WilleSWE/Adafroot-charger-MCP73833/KiCad project/kicad.md

This is the entire project, I'm pretty sure. Contains all of the stuff, including schematic
