WilleSWE/Adafroot-charger-MCP73833/KiCad project/Adafruit_MCP73833_PCB-master/production/bom.csv

Designator | Footprint | Quantity | Value | LCSC Part #
+ -_3 | JST_PH_B2B-PH-K_1x02_P2.00mm_Vertical | 1 | JST-PH 2.0mm
+ -_2 | Molex_PicoBlade_53047-0210_1x02_P1.25mm_Vertical | 1 | PicoBlade 1.25mm
+ - | JST_ZH_B2B-ZR_1x02_P1.50mm_Vertical | 1 | JST-ZH 1.5mm
5VIN | TestPoint_Pad_2.5x2.5mm | 1 | 5Vin
C1, C2 | 0603 | 2 | 10uF
GND | TestPoint_Pad_2.5x2.5mm | 1 | Gnd
IC1 | MSOP-10_3x3mm_P0.5mm | 1 | MCP73833-FCI_UN
J1 | USB4125GFA0190 | 1 | USB_C_Receptacle_PowerOnly_6P
J3 | PinHeader_1x02_P2.54mm_Vertical | 1 | Conn_01x02
J4 | PinHeader_2x05_P2.54mm_Vertical | 1 | Conn_02x05_Counter_Clockwise
LED1 | CHIPLED_0805 | 1 | STAT1-ORANGE
LED2 | CHIPLED_0805 | 1 | STAT2-GREEN
LED3 | CHIPLED_0805 | 1 | Power-RED
R1, R2, R3 | 0603 | 3 | 680 ohm 0603
R10 | R_Axial_DIN0207_L6.3mm_D2.5mm_P7.62mm_Horizontal | 1 | 1k ohm
R11 | R_Axial_DIN0207_L6.3mm_D2.5mm_P7.62mm_Horizontal | 1 | SPARE 2
R4 | R_Axial_DIN0207_L6.3mm_D2.5mm_P7.62mm_Horizontal | 1 | 10k ohm
R5, R6 | 0603 | 2 | 5k1
R7 | R_Axial_DIN0207_L6.3mm_D2.5mm_P7.62mm_Horizontal | 1 | 10K/THERM
R8 | R_Axial_DIN0207_L6.3mm_D2.5mm_P7.62mm_Horizontal | 1 | 4.7k ohm
R9 | R_Axial_DIN0207_L6.3mm_D2.5mm_P7.62mm_Horizontal | 1 | SPARE
