WilleSWE/Adafroot-charger-MCP73833/KiCad project/Adafruit_MCP73833_PCB-master/MCP73833_QFN_v1.0.kicad_pcb

## KiCad design KiCad project/Adafruit_MCP73833_PCB-master/MCP73833_QFN_v1.0.kicad_pcb (2026-10-17)

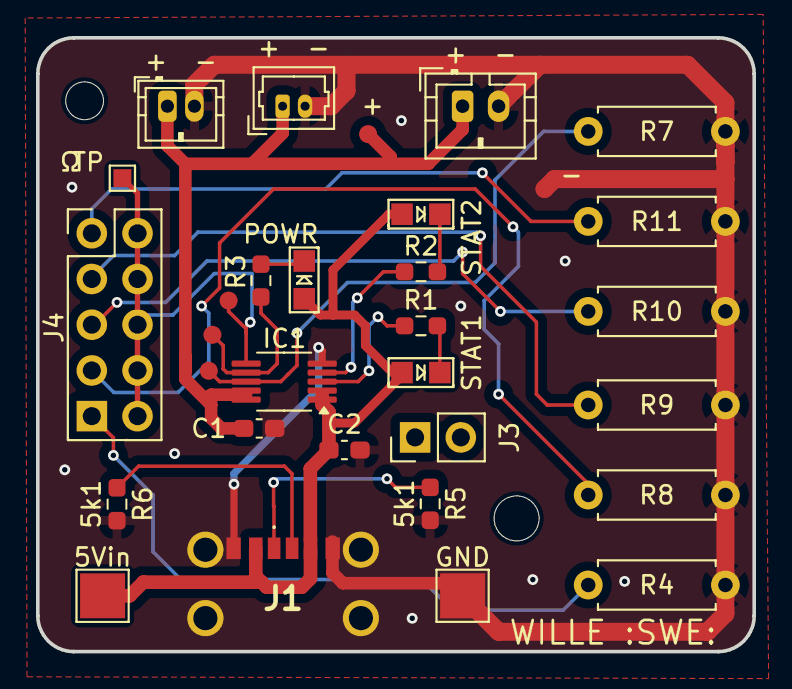
[picture p1: board MCP73833_QFN_v1.0.kicad_pcb from above]

Board: 2 copper layers, 39.8 x 34.1 mm, 26 parts (0 on the bottom side), 18 nets.

Parts:
5Vin: 5Vin; TestPoint_Pad_2.5x2.5mm
+  -: JST-PH 2.0mm; JST_PH_B2B-PH-K_1x02_P2.00mm_Vertical
+  -#2: PicoBlade 1.25mm; Molex_PicoBlade_53047-0210_1x02_P1.25mm_Vertical
+  -#3: JST-ZH 1.5mm; JST_ZH_B2B-ZR_1x02_P1.50mm_Vertical
C1, C2: 10uF; C_0603_1608Metric_Pad1.08x0.95mm_HandSolder
GND: Gnd; TestPoint_Pad_2.5x2.5mm
IC1: MCP73833-FCI_UN; MSOP-10_3x3mm_P0.5mm
J1: USB_C_Receptacle_PowerOnly_6P; USB4125GFA0190
J3: Conn_01x02; PinHeader_1x02_P2.54mm_Vertical
J4: Conn_02x05_Counter_Clockwise; PinHeader_2x05_P2.54mm_Vertical
LED1: STAT1-ORANGE; CHIPLED_0805
LED2: STAT2-GREEN; CHIPLED_0805
LED3: Power-RED; CHIPLED_0805
R1, R2, R3: 680 ohm 0603; R_0603_1608Metric_Pad0.98x0.95mm_HandSolder
R4: 10k ohm; R_Axial_DIN0207_L6.3mm_D2.5mm_P7.62mm_Horizontal
R5, R6: 5k1; R_0603_1608Metric_Pad0.98x0.95mm_HandSolder
R7: 10K/THERM; R_Axial_DIN0207_L6.3mm_D2.5mm_P7.62mm_Horizontal
R8: 4.7k ohm; R_Axial_DIN0207_L6.3mm_D2.5mm_P7.62mm_Horizontal
R9: SPARE; R_Axial_DIN0207_L6.3mm_D2.5mm_P7.62mm_Horizontal
R10: 1k ohm; R_Axial_DIN0207_L6.3mm_D2.5mm_P7.62mm_Horizontal
R11: SPARE 2; R_Axial_DIN0207_L6.3mm_D2.5mm_P7.62mm_Horizontal
TP: TestPoint_Pad_1.0x1.0mm

Connections:
5.0V: 5Vin.1, C2.1, IC1.1 (VDD_1), IC1.2 (VDD_2), J1.A9 (VBUS), J1.B9 (VBUS), LED1.A, LED2.A, LED3.A
GND: + -.2, + -#2.2, + -#3.2, C1.2, C2.2, GND.1, IC1.5 (VSS), J1.A12 (GND), J1.B12 (GND), J1.MH1, J1.MH2, J1.MH3, J1.MH4, R4.1, R5.2, R6.2, R7.1, R8.1, R9.1, R10.1, R11.1
unnamed: + -.1, + -#2.1, + -#3.1, C1.1, IC1.9 (VBAT_1), IC1.10 (VBAT_2)
unnamed: IC1.6 (PROG), J4.6, J4.7, J4.8, J4.9, J4.10, TP.1
unnamed: IC1.3 (STAT1), R1.1
unnamed: IC1.4 (STAT2), R2.1
unnamed: IC1.8 (THERM), R7.2
unnamed: IC1.7 (~PG), R3.2
unnamed: J1.A5 (CC1), R5.1
unnamed: J1.B5 (CC2), R6.1
unnamed: J4.1, R4.2
unnamed: J4.2, R8.2
unnamed: J4.3, R10.2
unnamed: J4.4, R9.2
unnamed: J4.5, R11.2
unnamed: LED1.C, R1.2
unnamed: LED2.C, R2.2
unnamed: LED3.C, R3.1
