WilleSWE/Adafroot-charger-MCP73833/KiCad project/Adafruit_MCP73833_PCB-master/MCP73833_QFN_v1.0.brd

## EAGLE design KiCad project/Adafruit_MCP73833_PCB-master/MCP73833_QFN_v1.0.brd (2026-10-17)

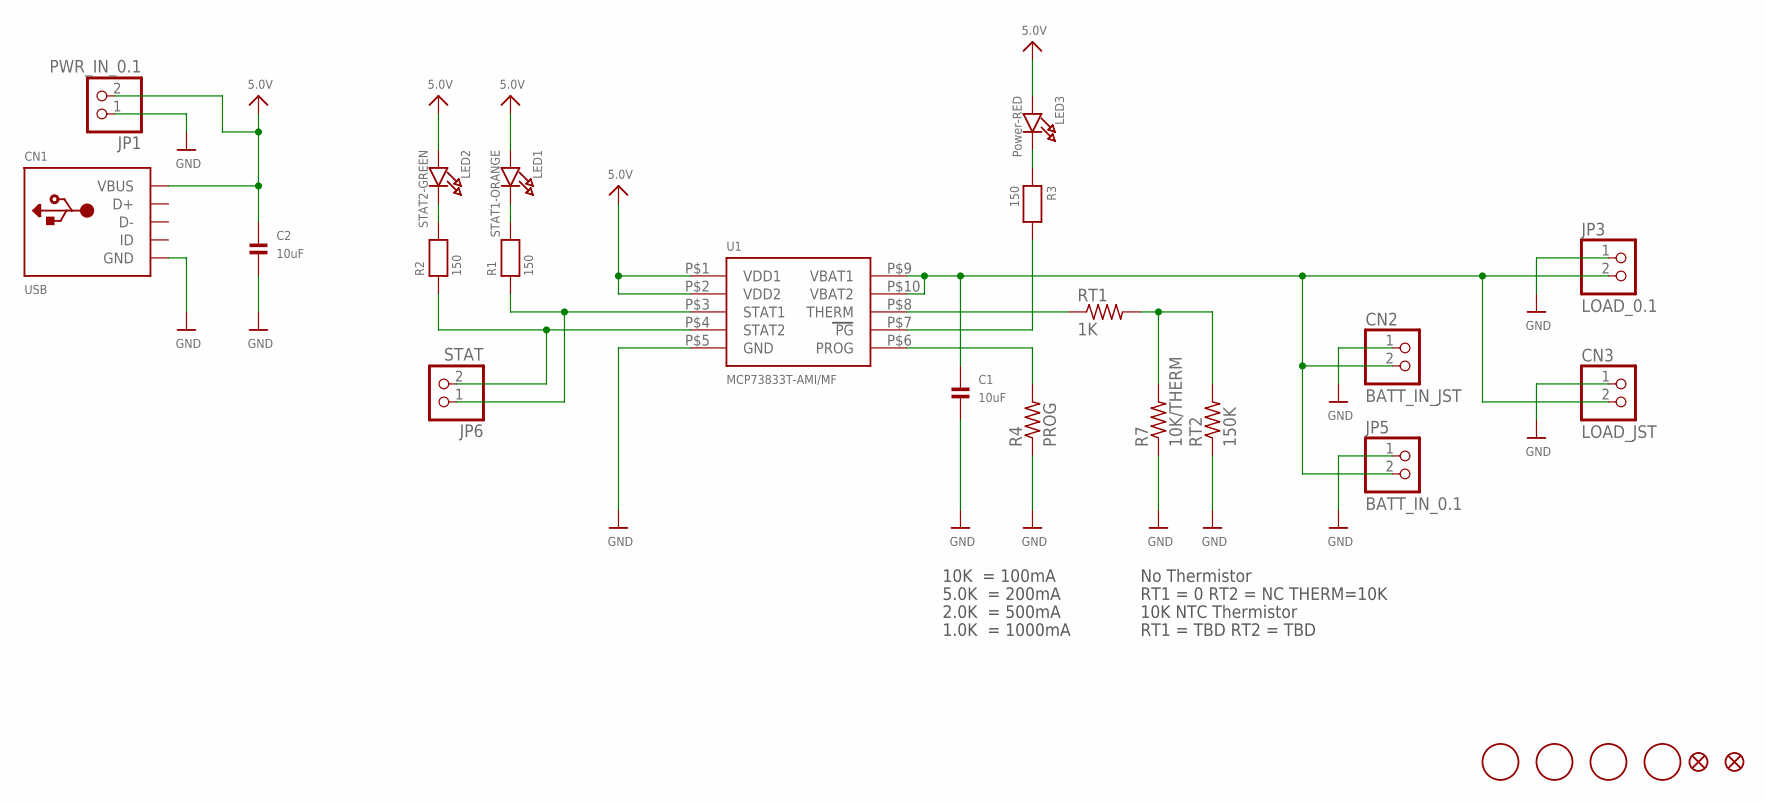
[picture p2: schematic MCP73833_QFN_v1.0.sch]

Parts:
C1, C2: 10uF; 0805
CN1: USB; USB-MINIB_LARGER
CN2: BATT_IN_JST; JSTPH2
CN3: LOAD_JST; JSTPH2
JP1: PWR_IN_0.1; 1X02_OVAL
JP2, JP4: FIDUCIAL1.5X3; FIDUCIAL-1X2.5
JP3: LOAD_0.1; 1X02_OVAL
JP5: BATT_IN_0.1; 1X02_OVAL
JP6: STAT; 1X02_OVAL
LED1: STAT1-ORANGE; CHIPLED_0805
LED2: STAT2-GREEN; CHIPLED_0805
LED3: Power-RED; CHIPLED_0805
R1, R2, R3: 150; 0805
R4: PROG; 0805-THM
R7: 10K/THERM; 0805-THM
RT1: 1K; R0805
RT2: 150K; R0805
U1: MCP73833T-AMI/MF; DFN10_3X3MM
U$11, U$16, U$18, U$19: MOUNTINGHOLE2.0; MOUNTINGHOLE_2.0_PLATED

Connections:
5.0V: C2.1, CN1.VBUS, JP1.2, LED1.A, LED2.A, LED3.A, U1.P$1 (VDD1), U1.P$2 (VDD2)
BATT: C1.1, CN2.2, CN3.2, JP3.2, JP5.2, U1.P$9 (VBAT1), U1.P$10 (VBAT2)
GND: C1.2, C2.2, CN1.GND, CN2.1, CN3.1, JP1.1, JP3.1, JP5.1, R4.1, R7.1, RT2.1, U1.P$5 (GND)
unnamed: LED1.C, R1.2
unnamed: LED2.C, R2.2
unnamed: JP6.1, R1.1, U1.P$3 (STAT1)
unnamed: JP6.2, R2.1, U1.P$4 (STAT2)
unnamed: RT1.1, U1.P$8 (THERM)
unnamed: R3.2, U1.P$7 (PG)
unnamed: R7.2, RT1.2, RT2.2
unnamed: LED3.C, R3.1
unnamed: R4.2, U1.P$6 (PROG)

Notes on the sheet:
10K = 100mA
5.0K = 200mA
2.0K = 500mA
1.0K = 1000mA
No Thermistor
RT1 = 0 RT2 = NC THERM=10K
10K NTC Thermistor
RT1 = TBD RT2 = TBD

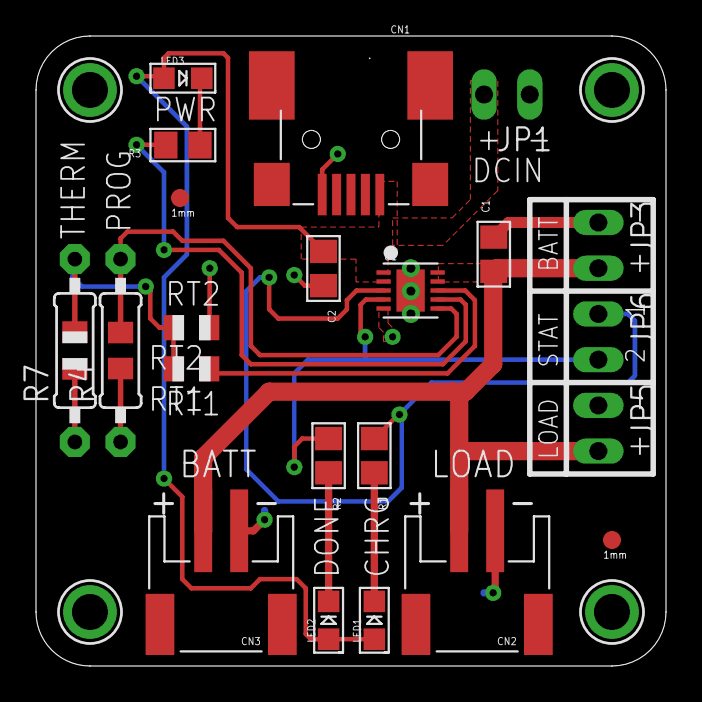
[picture p3: board MCP73833_QFN_v1.0.brd from above]

Board: 2 copper layers, 35.0 x 35.0 mm, 27 parts (1 on the bottom side), 12 nets.

Other parts of the board:
U$14: ADAFRUIT200MIL
