WilleSWE/Adafroot-charger-MCP73833/(commit log)

2026-10-17 Gerber files.
2026-10-17 Gerber files with correct timestamp
2026-10-17 Added kicad stuff
    [MCP73833_QFN_v1.0.brd, MCP73833_QFN_v1.0.kicad_pcb, MCP73833_QFN_v1.0.kicad_sch, MCP73833_QFN_v1.0.sch, bom.csv, designators.csv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]
